RinachanBoard31/agri_IoT/README.md

# agri_IoT

土壌水分センサを用いた潅水システムの評価に関する研究のプロジェクトファイルです。<br>
実験のために作成したモジュールのプログラムや配線図を公開しています。
