RinachanBoard31/agri_IoT/experiment1/Cost_of_each_area.pdf

タイマー区 | 日射区 | 水分センサ区 | EC区 | 温湿度気圧計 | 詳細 | 商品リンク
種類 | 商品概要 | 単価 | 個数 | 小計 | 個数 | 小計 | 個数 | 小計 | 個数 | 小計 | 個数 | 小計
マイコン | Raspberry Pi4 | ¥10,890 | 1 | ¥10,890 | 1 | ¥10,890 | Raspberry Pi 4 Model B / 4GB | https://www.switch-science.com/products/5680
Raspberry Pi OS用SSD | ¥3,620 | 1 | ¥3,620 | 1 | ¥3,620 | SSD-PUT250U3-BKC 外付けSSD USB-A接続

https://www.biccamera.com/bc/item/9284825/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 (https://www.biccamera.com/bc/item/9284825/)
ESP32 | ¥1,600 | 1 | ¥1,600 | 1 | ¥1,600 | 1 | ¥1,600 ESP-WROOM-32D開発ボード | https://akizukidenshi.com/catalog/g/g113628/ センサ | 日射計 | ¥23,000 | 1 | ¥23,000 | 三弘　PV日射センサー　PVSS-03　サンコー | https://store.shopping.yahoo.co.jp/sokuteikoubou-2/sanko-pvss-03.html
静電容量式センサ | ¥949 | 3 | ¥2,847 | 3 | ¥2,847 | SEN0193

https://www.digikey.jp/ja/products/detail/dfrobot/SEN0193/6588605?productid=6588605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 (https://www.digikey.jp/ja/products/detail/dfrobot/SEN0193/6588605?productid=6588605) RGfD_BwE

抵抗式センサ | ¥133 | 3 | ¥399 | KKHMF 土壌水分センサーモジュール LM393

https://www.amazon.co.jp/KKHMF-%E5%9C%9F%E5%A3%8C%E6%B0%B4%E5%88%86%E3%82%BB%E3%83%B3%E3%82%B5%E3%83%BC%E3%83%A2%E3%82%B8%E3%83%A5%E3%83%BC%E3%83%AB-LM393-%E5%9C%9F%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. (https://www.amazon.co.jp/KKHMF-%E5%9C%9F%E5%A3%8C%E6%B0%B4%E5%88%86%E3%82%BB%E3%83%B3%E3%82%B5%E3%83%BC%E3%83%A2%E3%82%B8%E3%83%A5%E3%83%BC%E3%83%AB-LM393-%E5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) b4ynXlDwOrFUIQ-c3AlJfpJYSAezVWaAH5-REOUWQ3s0g0nLmyg-MjM9tnNvXs7j0hPmi9c41n-

kdjefq_0eAknng0s6DFD2rjKk9azrONXv3f1A7-_XLw91uRvCN2SyiM3lTZ5GidxedIJlKnxI6aYP- (https://www.amazon.co.jp/KKHMF-%E5%9C%9F%E5%A3%8C%E6%B0%B4%E5%88%86%E3%82%BB%E3%83%B3%E3%82%B5%E3%83%BC%E3%83%A2%E3%82%B8%E3%83%A5%E3%83%BC%E3%83%AB-LM393-%E5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) KzG6pUNWbDDRtiu3ala5VXPuTsCbQUecJoNTh0gi- HDOofPAIvaodj40_YZ0TfeXiPc0SQK2j8A6aQXDjKGZWUbV8Wlq2Jtn9vpFQdN- FeBO6EThA7p6KPNvOeAQsmjOOUwTfgVEVZertnV7ss. YQrjR5WGujyaN3_5LMfOmfH34VyRrrj923Sfu_w4kuU&dib_tag=se&gclid=EAIaIQobChMIgMP0k4PMhAMVLRx7Bx2ps AneEAAYASAAEgIPbPD_BwE&hvadid=658685307598&hvdev=c&hvlocphy=1009281&hvnetw=g&hvqmt=e&hvrand=1

0524657584723256395&hvtargid=kwd-300239337262&hydadcr=4383_13326493&jp-ad-ap=0&keywords=%E5%9C% 9F%E5%A3%8C%E6%B0%B4%E5%88%86%E3%82%BB%E3%83%B3%E3%82%B5%E3%83% BC&qid=1709054235&sr=8-5 (https://www.amazon.co.jp/KKHMF-%E5%9C%9F%E5%A3%8C%E6%B0%B4%E5%88%86%E3%82%BB%E3%83%B3%E3%82%B5%E3%83%BC%E3%83%A2%E3%82%B8%E3%83%A5%E3%83%BC%E3%83%AB-LM393-%E5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)
BME280 | ¥1,380 | 1 | ¥1,380 BME280使用 温湿度・気圧センサモジュールキット | https://akizukidenshi.com/catalog/g/g109421/ 部品 | 100Vポンプ制御用リレー | ¥400 | 1 | ¥400 | 1 | ¥400 | 1 | ¥400 | 1 | ¥400 | ソリッド・ステート・リレー（ＳＳＲ）キット　２５Ａ（２０Ａ）タイプ | https://akizukidenshi.com/catalog/g/gK-00203/
配線コード黒 (1mあたり) | ¥30 | 1 | ¥30 | 1 | ¥30 | 31 | ¥930 | 61 | ¥1,830 | 配線コード 100m巻黒色 0.75sq
（+1m分は電源プラグに使用した分） | https://www.monotaro.com/p/0504/5102/ 配線コード赤 (1mあたり) | ¥30 | 30 | ¥900 | 60 | ¥1,800 | 配線コード 100m巻赤色 0.75sq | https://www.monotaro.com/p/0504/5118/ 配線コード青 (1mあたり) | ¥30 | 30 | ¥900 | 60 | ¥1,800 | 配線コード 100m巻青色 0.75sq | https://www.monotaro.com/p/0504/5136/
ADコンバータ | ¥240 | 1 | ¥240
１０ｂｉｔ　２ｃｈ　ＡＤコンバータ ＭＣＰ３００２－Ｉ／Ｐ | https://akizukidenshi.com/catalog/g/gI-02584/
コンデンサ | ¥25 | 1 | ¥25 | 1 | ¥25 | 1 | ¥25 積層セラミックコンデンサー 0.1μF250V | https://akizukidenshi.com/catalog/g/g110147/ 抵抗220Ω(1本あたり) | ¥2 | 3 | ¥6 | 3 | ¥6 | 3 | ¥6 | 3 | ¥6 | 3 | ¥6 カーボン抵抗(炭素皮膜抵抗) 1/2W220Ω | https://akizukidenshi.com/catalog/g/g107808/
フルカラーLED (1個あたり) | ¥45 | 1 | ¥45 | 1 | ¥45 | 1 | ¥45 | 1 | ¥45 | 1 | ¥45 ＲＧＢフルカラーＬＥＤ ５ｍｍ ＯＳＴＡ５１３１Ａ カソードコモン
（１０個入） | https://akizukidenshi.com/catalog/g/gI-03037/ ジャンパワイヤー (1本あたり) | ¥44 | 6 | ¥264 | 12 | ¥528 | 13 | ¥572 | 22 | ¥968 | 6 | ¥264 ジャンパワイヤ100本セット | ジャンパワイヤ100本セット ブレッドボード | ¥220 | 1 | ¥220 | 1 | ¥220 | 1 | ¥220 | 1 | ¥220 | 1 | ¥220 ブレッドボード BB-801 | https://akizukidenshi.com/catalog/g/g105294/ プラグオス&メス | ¥349 | 1 | ¥349 | 1 | ¥349 | 1 | ¥349 | 1 | ¥349 | 絶縁カバー付プラグのオスとメス | https://www.monotaro.com/g/00268264/ 合計 | ¥15,824 | ¥39,328 | ¥8,794 | ¥12,289 | ¥3,540
その他、全処理区に対して ネット環境 | ポケットWi-Fi (1ヶ月あたり) | ¥1,000 | 2 | ¥2,000 配線延長 | 熱伸縮チューブφ1.5(1mあたり) | ¥74 | 2 | ¥148
