RinachanBoard31/agri_IoT/experiment1/README.md

## 📁ファイル構成
- それぞれのフォルダには、各処理区のプログラムと配線図があります。
    - 1_timer area（タイマー区）
    - 2_solar radiation area（日射句）
    - 3_soil moisture area（水分センサ区）
    - 4_ec soil moisture area（EC区）
    - thermometer（温湿度気圧計）
- 各処理区を作るための部品内訳と費用は、"Cost_of_each_area.pdf" に記載しています。

## 🎥解説動画
- 水分センサ区について、導入方法を下記動画で解説しています。（画像をクリックするとYouTubeに飛びます）<br>
<a href="https://www.youtube.com/watch?v=40p7tEoAiwA">
    解説動画
</a>

## 🧑‍💻プログラム
### 共通LED設定
| LED色 | 状態 |
| :---: | :---|
| <font color="green">緑</font> | 正常に稼働中 |
| <font color="blue">青</font> | 潅水中 |
| <font color="purple">紫</font> | プログラムsetup中 |
| <font color="cyan">水</font> | 閾値をサーバから受信できた(EC区のみ) |
| <font color="red">赤</font> | センサの出力値が取得できない<br>Ambientにpostできない

---

### 1_タイマー区
**概要**
- 潅水回数、潅水する時間を毎日人手で設定し、設定に基づき潅水する
- 1回の潅水で、ポンプを20分間作動させる

**farm_area1.py**
1. 日付が変わった瞬間にGoogle Calendarを読み込み、潅水予定をirrigation.txtに出力する（プログラムが途中で止まっても潅水状況を保存できるようにするため）
2. irrigation.txtには潅水したかどうかの0/1と日付・時間を出力し、潅水を記録する
3. 1分ごとループを回し、潅水時間になったらorもし今より前に潅水するはずなのに潅水されていなかったら、潅水する
4. 潅水時は、irrigation.txtに1を上書きする
5. Ambientにpostする

**Raspi内での設定**
- cronで実行

**配線図**<br>
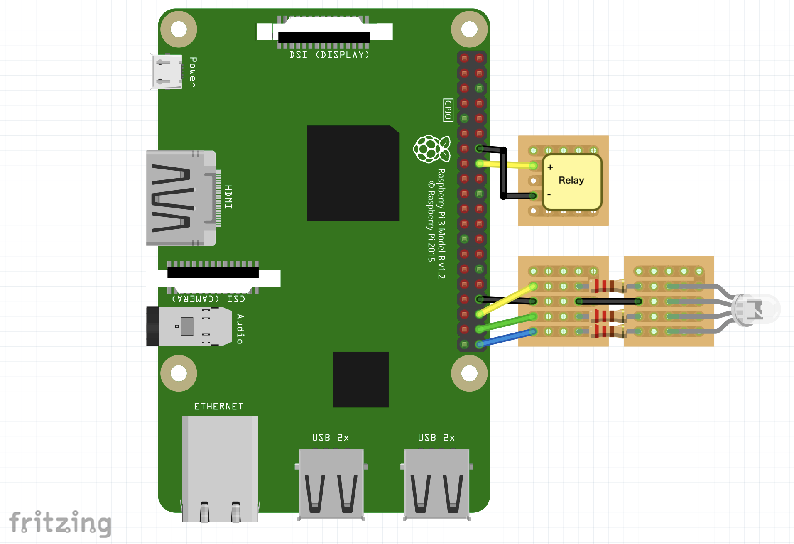
[picture p1: experiment1/1_timer area/wiring_area1.png]

<br>LEDを保護するため、抵抗を挟むことをお勧めします。

---

### 2_日射区
**概要**
- 積算日射量を測定し、0.6MJを超えたとき3分間潅水する
- 潅水後に積算日射量の値を0にリセットする
- 潅水したくない夕方〜夜の時間帯は閾値を超えても潅水せず、日射量を蓄積する

**farm_area2.py**
1. 積算日射量をval_total.txtとして出力する（プログラムが途中で止まっても積算日射量を保持できるようにするため）
2. 1回のタームは60秒間で、ターム内の合計値はval_sum、全体の合計値はval_totalに格納する
3. 60秒間測定したら、ターム内の平均値をval_aveとして格納する
4. val_totalが閾値を超え、かつ現在時刻が潅水時間を満たしていたら潅水する
5. 潅水時はval_totalを0にする
6. val_total.txtを更新し、Ambientにpostする

**Raspi内での設定**
- cronで実行

**配線図**<br>
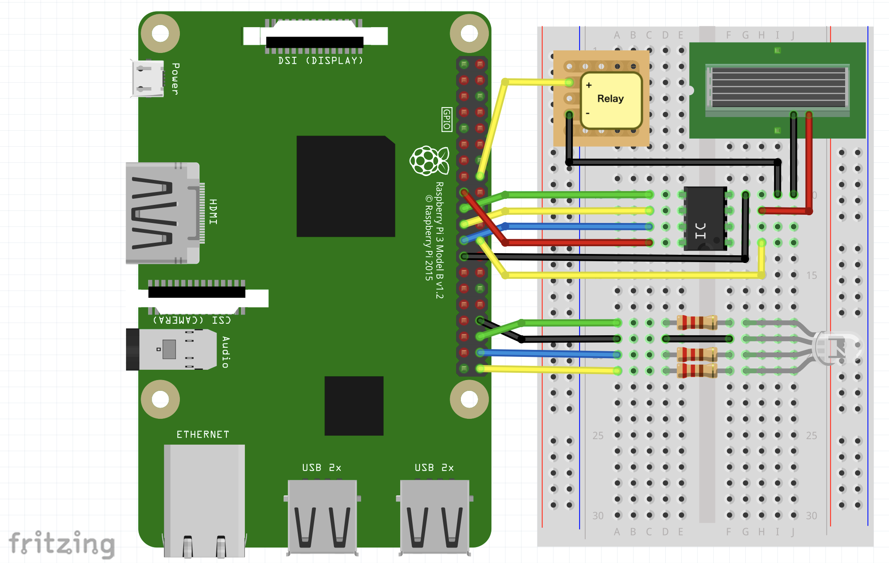
[picture p2: experiment1/2_solar radiation area/wiring_area2.png]


---

### 3_水分センサ区
**概要**
- SEN0193をそれぞれ3つのメロンに用いて体積含水率の平均値を算出する
- 体積含水率が、32%を下回ったとき5分間潅水する
- 潅水後30分間は、潅水しない

**farm-area3.ino**
1. SEN0193を測定し、それぞれanalogread()の値が1000を超えていたら正常に測定できたと判断して測定対象にし、平均値・体積含水率を算出する
2. 体積含水率が閾値を下回っていて、かつ前回の潅水から30分以上経過していたら(irrigation_countdown==0)潅水する
3. Ambientにpostする
4. SENSING_INTERVALに定義した時間の分だけdelay()

**配線図**<br>
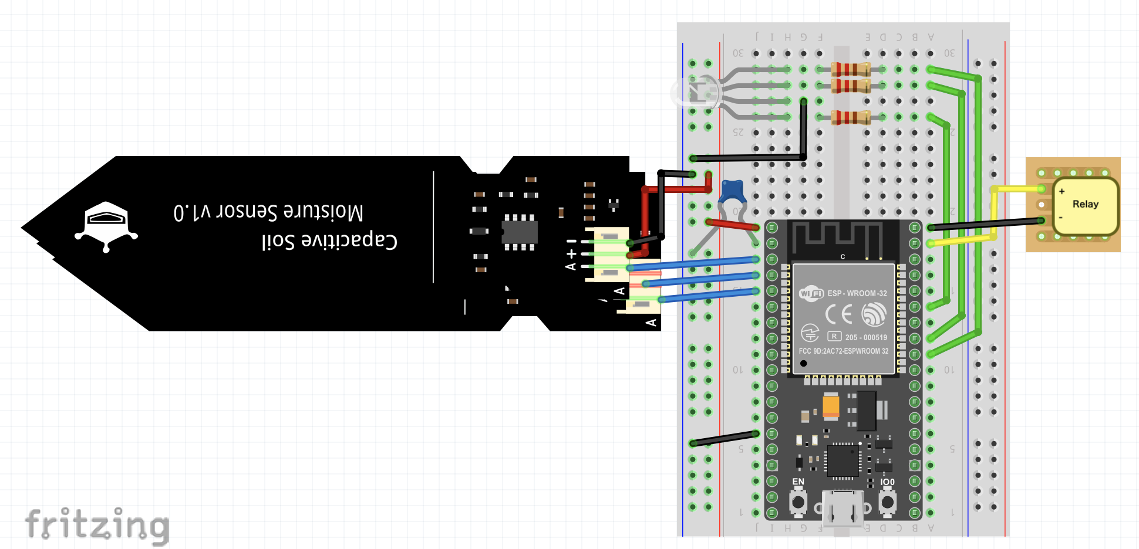
[picture p3: experiment1/3_soil moisture area/wiring_area3.png]


---

### 4_EC区
**概要**
- SEN0193, LM393をそれぞれ3つのメロンに用いて体積含水率の平均値を算出する
- 体積含水率が、31%を下回ったとき5分間潅水する
- 潅水後30分間は、潅水しない
- 閾値はGoogle Sheetsからユーザが変更できる

**farm-area4.ino**
1. LM393, SEN0193の順に測定、それぞれanalogread()の値が1000を超えていたら正常に測定できたと判断して測定対象にし、平均値・体積含水率を算出する
2. Google Sheetsから閾値を取得する。このとき、まずタイマー区のRaspiが閾値を取得してサーバを立て、閾値を返せるように準備しており（farm_area4_server.py）、EC区のESP32からリクエストを送って取得する
3. 体積含水率が閾値を下回っていて、かつ前回の潅水から30分以上経過していたら(irrigation_countdown==0)潅水する
4. Ambientにpostする
5. SENSING_INTERVALに定義した時間の分だけdelay()

**配線図**<br>
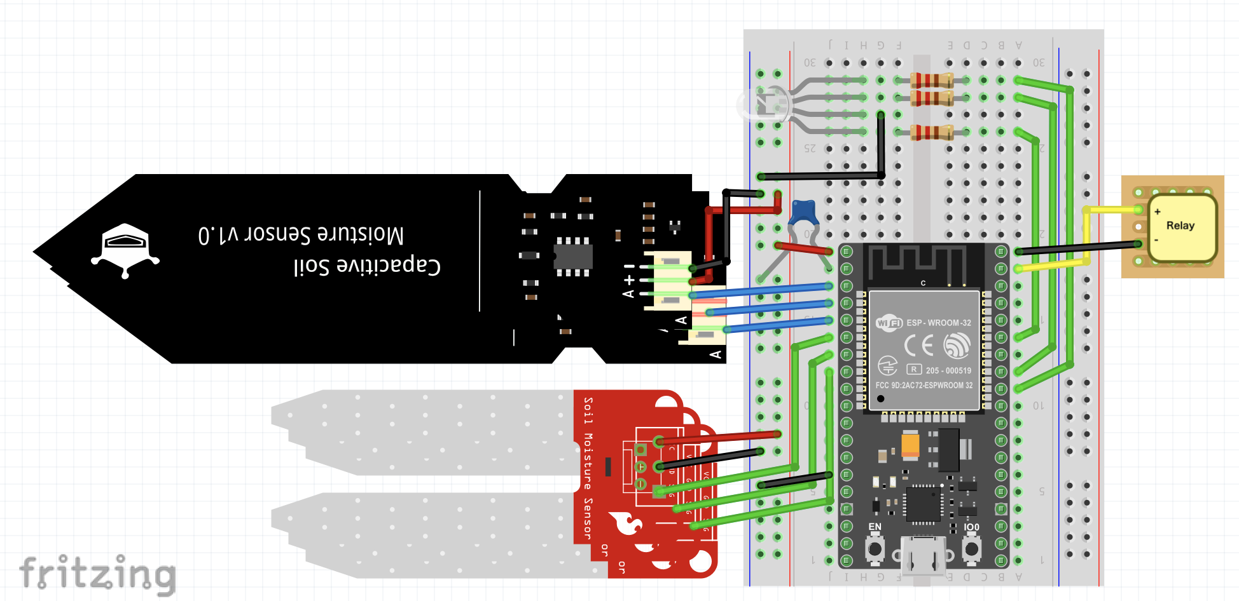
[picture p4: experiment1/4_ec soil moisture area/wiring_area4.png]


---

### 温湿度気圧計
**概要**
- 温度・湿度・気圧を毎分測定する

**thermometer.ino**
1. 温度・湿度・気圧をI2C通信で測定する
2. Ambientにpostする
3. SENSING_INTERVALに定義した時間の分だけdelay()

**配線図**<br>
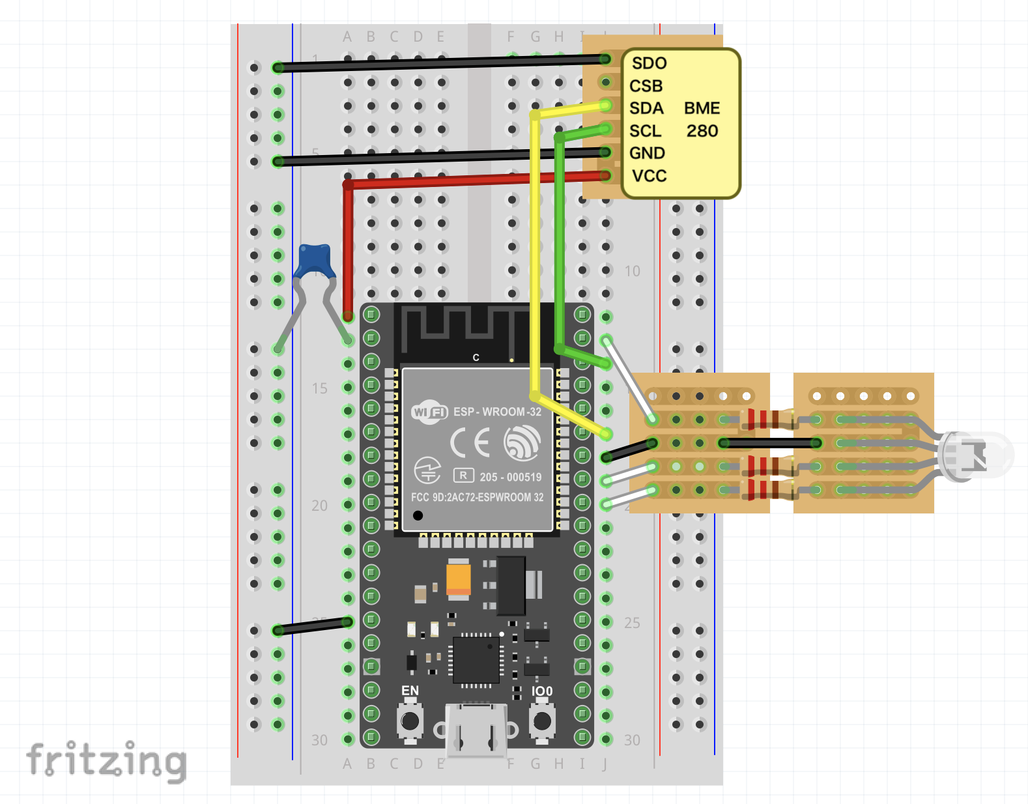
[picture p5: experiment1/thermometer/wiring_thermometer.png]
