RinachanBoard31/agri_IoT/(commit log)

2024-03-01 add wiring diagram, edit md
2024-06-28 add resistances to wiring diagrams
2024-06-28 add resistances and tube to cost table
2024-08-24 change threshold to correct value
    [farm-area3.ino, farm-area4.ino]
